MitchiLaser/MAXwel/examples/led_blink/README.md

# BIN2HEX

This example uses the 50 MHz onboard oscillator and divides the frequency down to 1 Hz. The output signal of the frequency divider is used to let an LED blink. Open the `.qpf` file with Quartus to view the source, compile the project and upload it to the device.
