MitchiLaser/MAXwel/examples/bin2hex/README.md

# BIN2HEX

This example project takes a binary number input from the 8 switches and displays the corresponding 2-digit hexadecimal number on the 7-segment displays. Open the `.qpf` file with Quartus to view the source, compile the project and upload it to the device.
