MitchiLaser/MAXwel/docs/fig/Floorplan.pdf

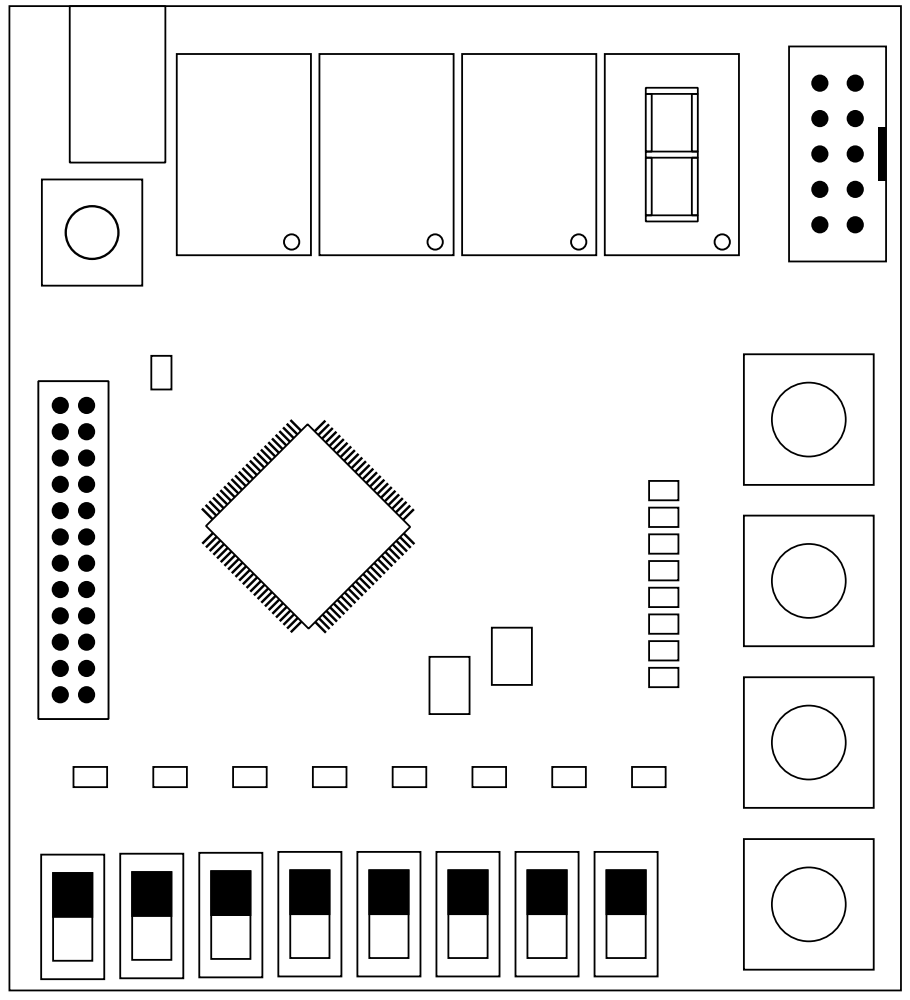
[picture p8: page 1]
