MitchiLaser/MAXwel/docs/fig/Progheader.pdf

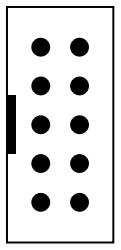
[picture p9: figure]
