MitchiLaser/MAXwel/hardware/Landing_Page_QR.png

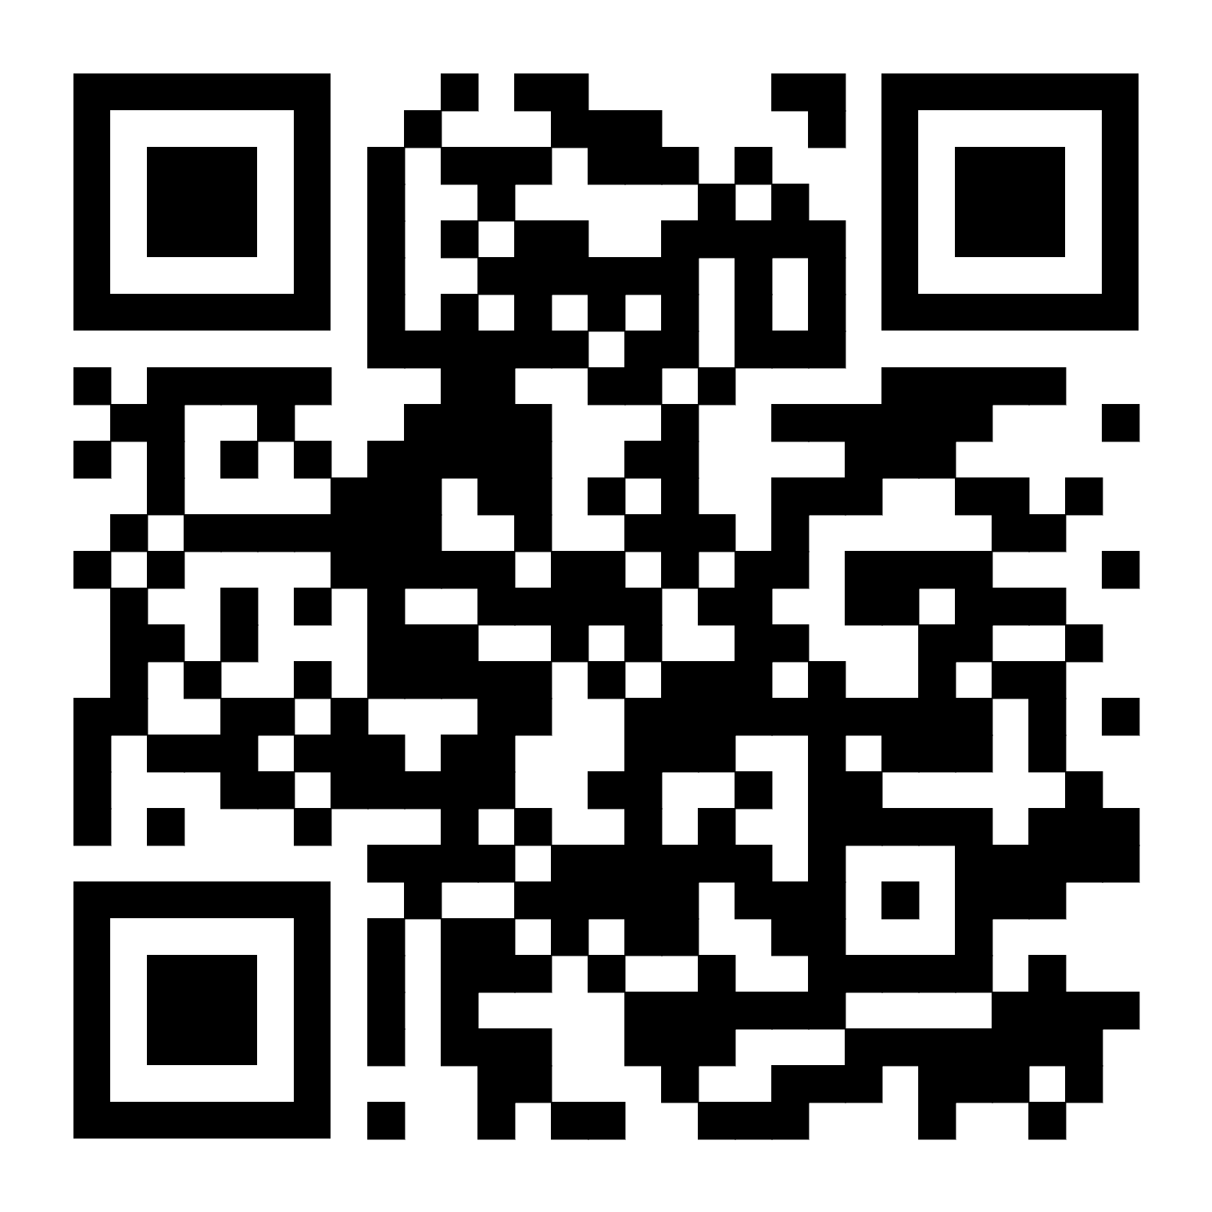
hardware/Landing_Page_QR.png
