MitchiLaser/MAXwel/hardware/MAXwel.kicad_pcb

## KiCad design hardware/MAXwel.kicad_pcb (2024-12-23)

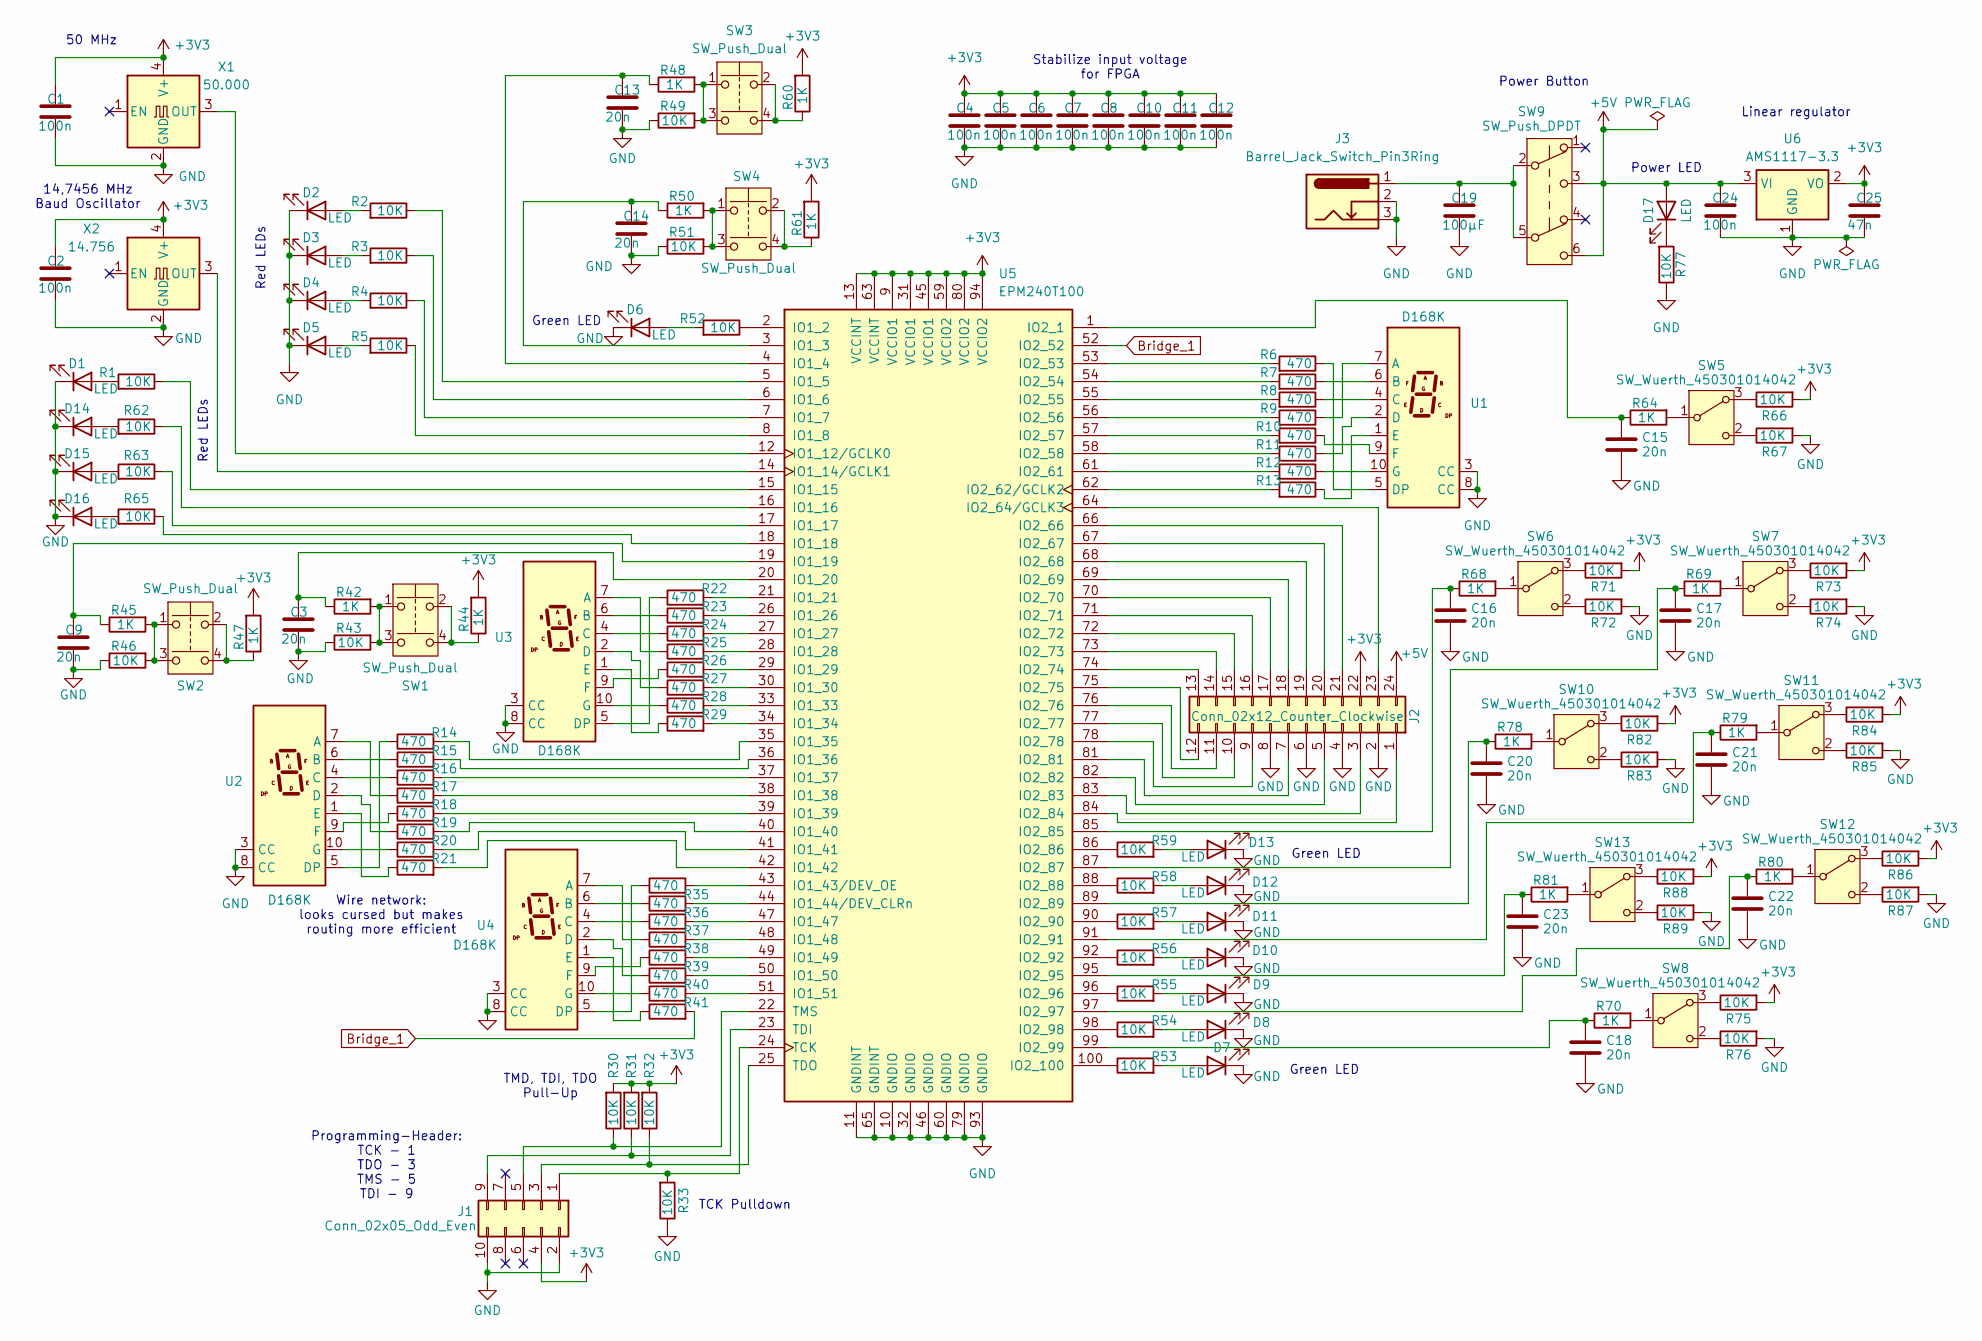
[picture p13: schematic MAXwel.kicad_sch]

Parts:
C1, C2, C4, C5, C6, C7, C8, C10, C11, C12, C24: 100n; C_0603_1608Metric_Pad1.08x0.95mm_HandSolder
C3, C9, C13, C14, C15, C16, C17, C18, C20, C21, C22, C23: 20n; C_0603_1608Metric_Pad1.08x0.95mm_HandSolder
C19: 100µF; CP_Radial_D5.0mm_P2.00mm; Part-Nr M-A 100U 16-2
C25: 47n; C_0603_1608Metric_Pad1.08x0.95mm_HandSolder
D1, D2, D3, D4, D5, D6, D7, D8, D9, D10, D11, D12, D13, D14, D15, D16, D17: LED; LED_0805_2012Metric_Pad1.15x1.40mm_HandSolder
J1: Conn_02x05_Odd_Even; IDC-Header_2x05_P2.54mm_Vertical
J2: Conn_02x12_Counter_Clockwise; PinHeader_2x12_P2.54mm_Horizontal
J3: Barrel_Jack_Switch_Pin3Ring; BarrelJack_Horizontal; Part-Nr CLIFF FCR681465
R1, R2, R3, R4, R5, R52, R53, R54, R55, R56, R57, R58, R59, R62, R63, R65, R77: 10K; R_0603_1608Metric_Pad0.98x0.95mm_HandSolder
R6, R7, R8, R9, R10, R11, R12, R13, R14, R15, R16, R17, R18, R19, R20, R21, R22, R23, R24, R25, R26, R27, R28, R29, R34, R35, R36, R37, R38, R39, R40, R41: 470; R_0603_1608Metric_Pad0.98x0.95mm_HandSolder
R30, R31, R32, R33, R43, R46, R49, R51, R66, R67, R71, R72, R73, R74, R75, R76, R82, R83, R84, R85, R86, R87, R88, R89: 10K; R_0603_1608Metric_Pad0.98x0.95mm_HandSolder; Part-Nr OMR B3F-4000
R42, R44, R45, R47, R48, R50, R60, R61, R64, R68, R69, R70, R78, R79, R80, R81: 1K; R_0603_1608Metric_Pad0.98x0.95mm_HandSolder; Part-Nr OMR B3F-4000
SW1, SW2, SW3, SW4: SW_Push_Dual; SW_PUSH-12mm
SW5, SW6, SW7, SW8, SW10, SW11, SW12, SW13: SW_Wuerth_450301014042; SW_Slide_SPDT_Straight_12.8mm_6.9mm; LCSC C5155552
SW9: SW_Push_DPDT; SW_Push_2P2T_Toggle_CK_PVA2OAH5xxxxxxV2
U1, U2: D168K; D1X8K; Part-Nr SA 56-11 RT
U3, U4: D168K; D1X8K; Part-Nr SA 56-11 RT Alternative: SC 39-11 GN
U5: EPM240T100; TQFP-100_14x14mm_P0.5mm; Part-Nr EPM 240T100 C5N
U6: AMS1117-3.3; SOT-223-3_TabPin2
X1: 50.000; Oscillator_SMD_EuroQuartz_XO53-4Pin_5.0x3.2mm_HandSoldering; LCSC C387308
X2: 14.756; Oscillator_SMD_EuroQuartz_XO53-4Pin_5.0x3.2mm_HandSoldering; LCSC C7431374

Connections:
+3V3: C1.1, C2.1, C4.1, C5.1, C6.1, C7.1, C8.1, C10.1, C11.1, C12.1, C25.1, J1.4, J2.22, R30.2, R31.2, R32.2, R44.2, R47.2, R60.2, R61.2, R66.2, R71.2, R73.2, R75.2, R82.2, R84.2, R86.2, R88.2, U5.9 (VCCIO1), U5.13 (VCCINT), U5.31 (VCCIO1), U5.45 (VCCIO1), U5.59 (VCCIO2), U5.63 (VCCINT), U5.80 (VCCIO2), U5.94 (VCCIO2), U6.2 (VO), X1.4 (V+), X2.4 (V+)
+5V: C24.1, D17.2 (A), J2.24, SW9.3 (C), SW9.6 (C), U6.3 (VI)
Bridge_1: R41.2, U5.52 (IO2_52)
GND: C1.2, C2.2, C3.2, C4.2, C5.2, C6.2, C7.2, C8.2, C9.2, C10.2, C11.2, C12.2, C13.2, C14.2, C15.2, C16.2, C17.2, C18.2, C19.2, C20.2, C21.2, C22.2, C23.2, C24.2, C25.2, D1.1 (K), D2.1 (K), D3.1 (K), D4.1 (K), D5.1 (K), D6.1 (K), D7.1 (K), D8.1 (K), D9.1 (K), D10.1 (K), D11.1 (K), D12.1 (K), D13.1 (K), D14.1 (K), D15.1 (K), D16.1 (K), J1.2, J1.10, J2.2, J2.4, J2.6, J2.8, J3.2, J3.3, R33.1, R43.1, R46.1, R49.1, R51.1, R67.2, R72.2, R74.2, R76.2, R77.1, R83.2, R85.2, R87.2, R89.2, U1.3 (CC), U1.8 (CC), U2.3 (CC), U2.8 (CC), U3.3 (CC), U3.8 (CC), U4.3 (CC), U4.8 (CC), U5.10 (GNDIO), U5.11 (GNDINT), U5.32 (GNDIO), U5.46 (GNDIO), U5.60 (GNDIO), U5.65 (GNDINT), U5.79 (GNDIO), U5.93 (GNDIO), U6.1 (GND), X1.2 (GND), X2.2 (GND)
unnamed: C19.1, J3.1, SW9.2 (B), SW9.5 (B)
unnamed: D1.2 (A), R1.2
unnamed: D2.2 (A), R2.2
unnamed: D3.2 (A), R3.2
unnamed: D4.2 (A), R4.2
unnamed: D5.2 (A), R5.2
unnamed: D6.2 (A), R52.2
unnamed: D7.2 (A), R53.2
unnamed: D8.2 (A), R54.2
unnamed: D9.2 (A), R55.2
unnamed: D10.2 (A), R56.2
unnamed: D11.2 (A), R57.2
unnamed: D12.2 (A), R58.2
unnamed: D13.2 (A), R59.2
unnamed: D14.2 (A), R62.2
unnamed: D15.2 (A), R63.2
unnamed: D16.2 (A), R65.2
unnamed: D17.1 (K), R77.2
unnamed: J1.1, R33.2, U5.24 (TCK)
unnamed: J1.3, R32.1, U5.25 (TDO)
unnamed: J1.5, R30.1, U5.22 (TMS)
unnamed: J1.9, R31.1, U5.23 (TDI)
unnamed: J2.1, U5.84 (IO2_84)
unnamed: J2.3, U5.83 (IO2_83)
unnamed: J2.5, U5.82 (IO2_82)
unnamed: J2.7, U5.81 (IO2_81)
unnamed: J2.9, U5.78 (IO2_78)
unnamed: J2.10, U5.77 (IO2_77)
unnamed: J2.11, U5.76 (IO2_76)
unnamed: J2.12, U5.75 (IO2_75)
unnamed: J2.13, U5.74 (IO2_74)
unnamed: J2.14, U5.73 (IO2_73)
unnamed: J2.15, U5.72 (IO2_72)
unnamed: J2.16, U5.71 (IO2_71)
unnamed: J2.17, U5.70 (IO2_70)
unnamed: J2.18, U5.69 (IO2_69)
unnamed: J2.19, U5.68 (IO2_68)
unnamed: J2.20, U5.67 (IO2_67)
unnamed: J2.21, U5.66 (IO2_66)
unnamed: J2.23, U5.64 (IO2_64/GCLK3)
unnamed: R42.2, R43.2, SW1.1, SW1.3
unnamed: R44.1, SW1.2, SW1.4
unnamed: R45.2, R46.2, SW2.1, SW2.3
unnamed: R47.1, SW2.2, SW2.4
unnamed: R48.2, R49.2, SW3.1, SW3.3
unnamed: R50.2, R51.2, SW4.1, SW4.3
unnamed: R60.1, SW3.2, SW3.4
unnamed: R61.1, SW4.2, SW4.4
unnamed: R66.1, SW5.3 (A)
unnamed: R64.2, SW5.1 (B)
unnamed: R67.1, SW5.2 (C)
unnamed: R71.1, SW6.3 (A)
unnamed: R68.2, SW6.1 (B)
unnamed: R72.1, SW6.2 (C)
unnamed: R73.1, SW7.3 (A)
unnamed: R69.2, SW7.1 (B)
unnamed: R74.1, SW7.2 (C)
unnamed: R75.1, SW8.3 (A)
unnamed: R70.2, SW8.1 (B)
unnamed: R76.1, SW8.2 (C)
unnamed: R82.1, SW10.3 (A)
unnamed: R78.2, SW10.1 (B)
unnamed: R83.1, SW10.2 (C)
unnamed: R84.1, SW11.3 (A)
unnamed: R79.2, SW11.1 (B)
unnamed: R85.1, SW11.2 (C)
unnamed: R86.1, SW12.3 (A)
unnamed: R80.2, SW12.1 (B)
unnamed: R87.1, SW12.2 (C)
unnamed: R88.1, SW13.3 (A)
unnamed: R81.2, SW13.1 (B)
unnamed: R89.1, SW13.2 (C)
unnamed: R9.1, U1.7 (A)
unnamed: R7.1, U1.6 (B)
unnamed: R8.1, U1.4 (C)
unnamed: R11.1, U1.2 (D)
unnamed: R6.1, U1.5 (DP)
unnamed: R13.1, U1.1 (E)
unnamed: R10.1, U1.9 (F)
unnamed: R12.1, U1.10 (G)
unnamed: R17.1, U2.7 (A)
unnamed: R15.1, U2.6 (B)
unnamed: R16.1, U2.4 (C)
unnamed: R19.1, U2.2 (D)
unnamed: R14.1, U2.5 (DP)
unnamed: R21.1, U2.1 (E)
unnamed: R18.1, U2.9 (F)
unnamed: R20.1, U2.10 (G)
unnamed: R25.1, U3.7 (A)
unnamed: R23.1, U3.6 (B)
unnamed: R24.1, U3.4 (C)
unnamed: R27.1, U3.2 (D)
unnamed: R22.1, U3.5 (DP)
unnamed: R29.1, U3.1 (E)
unnamed: R26.1, U3.9 (F)
unnamed: R28.1, U3.10 (G)
unnamed: R37.1, U4.7 (A)
unnamed: R35.1, U4.6 (B)
unnamed: R36.1, U4.4 (C)
unnamed: R39.1, U4.2 (D)
unnamed: R34.1, U4.5 (DP)
unnamed: R41.1, U4.1 (E)
unnamed: R38.1, U4.9 (F)
unnamed: R40.1, U4.10 (G)
unnamed: R52.1, U5.2 (IO1_2)
unnamed: C14.1, R50.1, U5.3 (IO1_3)
unnamed: C13.1, R48.1, U5.4 (IO1_4)
unnamed: R2.1, U5.5 (IO1_5)
unnamed: R3.1, U5.6 (IO1_6)
unnamed: R4.1, U5.7 (IO1_7)
unnamed: R5.1, U5.8 (IO1_8)
unnamed: U5.12 (IO1_12/GCLK0), X1.3 (OUT)
unnamed: U5.14 (IO1_14/GCLK1), X2.3 (OUT)
unnamed: R1.1, U5.15 (IO1_15)
unnamed: R62.1, U5.16 (IO1_16)
unnamed: R63.1, U5.17 (IO1_17)
unnamed: R65.1, U5.18 (IO1_18)
unnamed: C9.1, R45.1, U5.19 (IO1_19)
unnamed: C3.1, R42.1, U5.20 (IO1_20)
unnamed: R22.2, U5.21 (IO1_21)
unnamed: R23.2, U5.26 (IO1_26)
unnamed: R24.2, U5.27 (IO1_27)
unnamed: R25.2, U5.28 (IO1_28)
unnamed: R26.2, U5.29 (IO1_29)
unnamed: R27.2, U5.30 (IO1_30)
unnamed: R28.2, U5.33 (IO1_33)
unnamed: R29.2, U5.34 (IO1_34)
unnamed: R14.2, U5.35 (IO1_35)
unnamed: R15.2, U5.36 (IO1_36)
unnamed: R16.2, U5.37 (IO1_37)
unnamed: R17.2, U5.38 (IO1_38)
unnamed: R18.2, U5.39 (IO1_39)
unnamed: R19.2, U5.40 (IO1_40)
unnamed: R20.2, U5.41 (IO1_41)
unnamed: R21.2, U5.42 (IO1_42)
unnamed: R34.2, U5.43 (IO1_43/DEV_OE)
unnamed: R35.2, U5.44 (IO1_44/DEV_CLRn)
unnamed: R36.2, U5.47 (IO1_47)
unnamed: R37.2, U5.48 (IO1_48)
unnamed: R38.2, U5.49 (IO1_49)
unnamed: R39.2, U5.50 (IO1_50)
unnamed: R40.2, U5.51 (IO1_51)
unnamed: C15.1, R64.1, U5.1 (IO2_1)
unnamed: R6.2, U5.53 (IO2_53)
unnamed: R7.2, U5.54 (IO2_54)
unnamed: R8.2, U5.55 (IO2_55)
unnamed: R9.2, U5.56 (IO2_56)
unnamed: R10.2, U5.57 (IO2_57)
unnamed: R11.2, U5.58 (IO2_58)
unnamed: R12.2, U5.61 (IO2_61)
unnamed: R13.2, U5.62 (IO2_62/GCLK2)
unnamed: C16.1, R68.1, U5.85 (IO2_85)
unnamed: R59.1, U5.86 (IO2_86)
unnamed: C17.1, R69.1, U5.87 (IO2_87)
unnamed: R58.1, U5.88 (IO2_88)
unnamed: C20.1, R78.1, U5.89 (IO2_89)
unnamed: R57.1, U5.90 (IO2_90)
unnamed: C21.1, R79.1, U5.91 (IO2_91)
unnamed: R56.1, U5.92 (IO2_92)
unnamed: C23.1, R81.1, U5.95 (IO2_95)
unnamed: R55.1, U5.96 (IO2_96)
unnamed: C22.1, R80.1, U5.97 (IO2_97)
unnamed: R54.1, U5.98 (IO2_98)
unnamed: C18.1, R70.1, U5.99 (IO2_99)
unnamed: R53.1, U5.100 (IO2_100)

Notes on the sheet:
Green LED
Wire network: looks cursed but makes routing more efficient
Stabilize input voltage for FPGA
Programming-Header: TCK - 1 TDO - 3 TMS - 5 TDI - 9
TMD, TDI, TDO Pull-Up
Power Button
TCK Pulldown
14,7456 MHz Baud Oscillator
50 MHz
Linear regulator
Red LEDs
Power LED

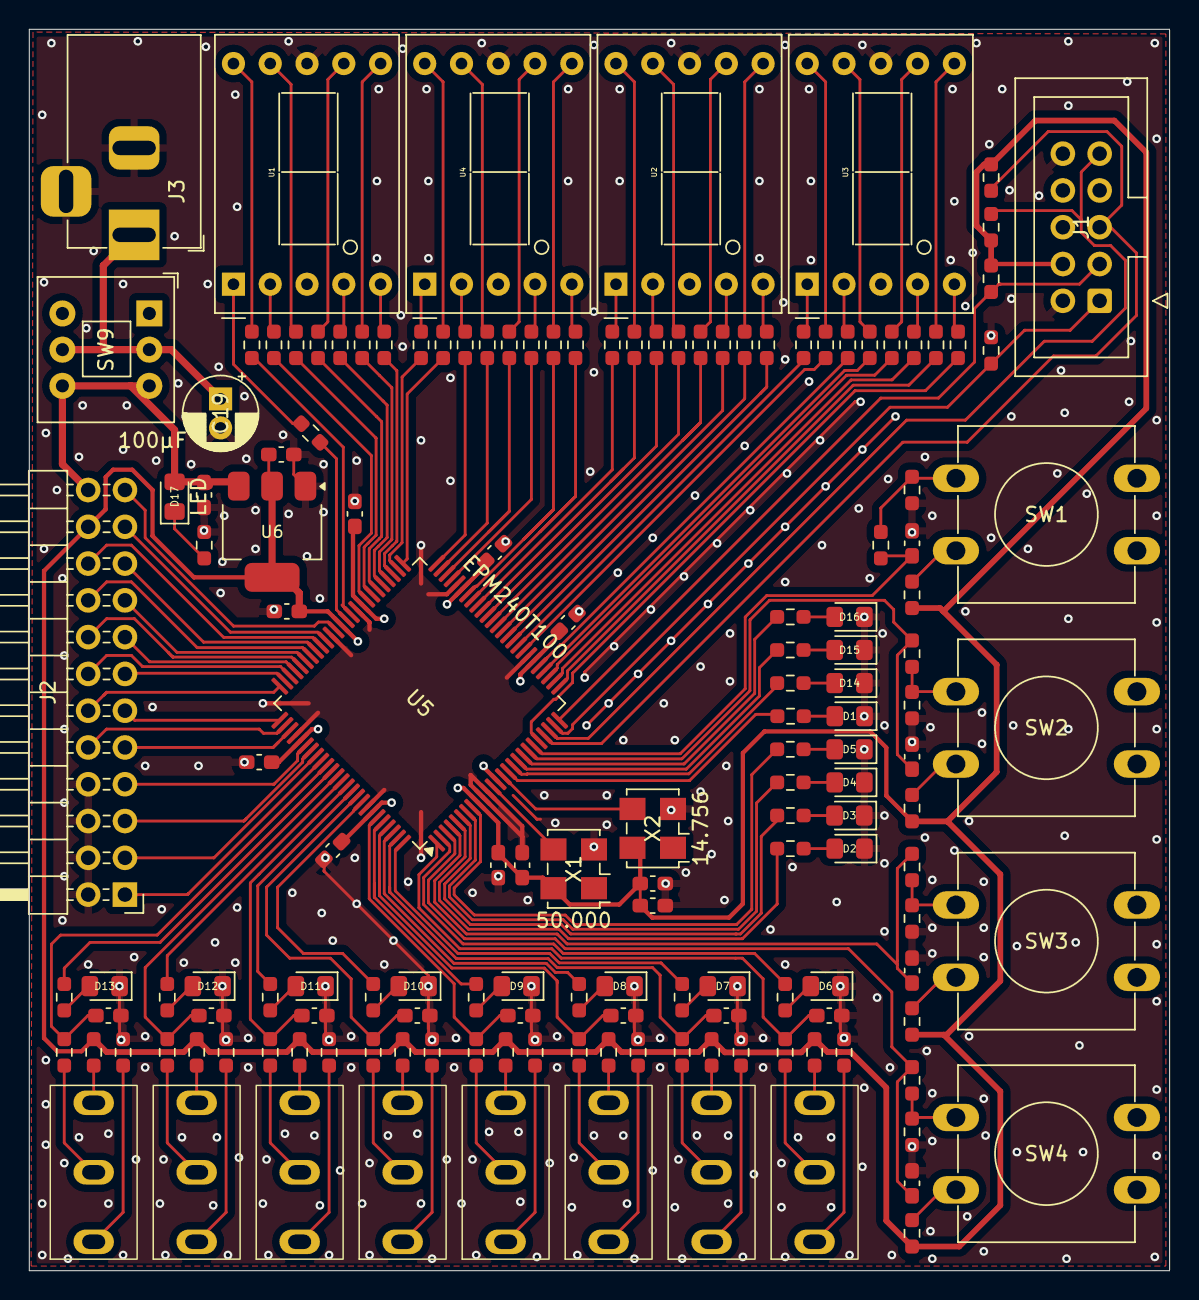
[picture p14: board MAXwel.kicad_pcb from above]

Board: 2 copper layers, 78.7 x 85.7 mm, 155 parts (0 on the bottom side), 169 nets.
