MitchiLaser/MAXwel/(commit log)

2024-06-05 all leds placed on the board
    [MAXwell.kicad_pcb, MAXwell.kicad_sch]
2024-06-05 restructure + buttons added
    [MAXwell.kicad_sch]
2024-06-06 restructured » more Space
    [MAXwell.kicad_sch]
2024-06-06 all objects placed, footprint assignment missing
    [MAXwell.kicad_sch]
2024-06-06 all footprints assigned
    [MAXwell.kicad_sch]
2024-06-06 ERC applied and fixed missing power flags
    [MAXwell.kicad_pcb, MAXwell.kicad_sch]
2024-06-07 started routing
    [MAXwell.kicad_pcb, MAXwell.kicad_sch]
2024-06-07 pcb outline defined, ready for autorouter test
    [MAXwell.kicad_pcb]
2024-06-07 partially done 1/4
    [MAXwell.kicad_pcb]
2024-06-07 nearly done
    [MAXwell.kicad_pcb]
2024-06-07 last attempt to autorouter
    [MAXwell.kicad_pcb]
2024-06-07 routing done
    [MAXwell.kicad_pcb]
2024-06-07 cleanup pcb design
    [MAXwell.kicad_pcb]
2024-06-07 replaced GND traces on backside with ground plane
    [MAXwell.kicad_pcb]
2024-06-08 established ground planes
    [MAXwell.kicad_pcb]
2024-06-08 remove reference from silkscreen
    [MAXwell.kicad_pcb]
2024-06-08 put values on silk screen
    [MAXwell.kicad_pcb]
2024-06-08 first production run
    [MAXwell.kicad_pcb]
2024-06-08 fixed wrong part number
    [MAXwell.kicad_sch]
2024-06-10 fill README with content + Rename project
    [MAXwel.kicad_pcb, MAXwel.kicad_sch]
2024-06-19 starting with landingpage and restructuring templates
2024-06-19 landing page for gh pages
2024-06-19 update README » landing page
2024-06-19 empty template for schematic project
2024-06-19 fixed missing file in schematics template
2024-06-20 fixed wrong footprint for slide switches
    [MAXwel.kicad_pcb]
2024-07-22 change resistor and capacitor size, rearrange pinheader and 7-seg connections
    [MAXwel.kicad_pcb, MAXwel.kicad_sch]
2024-07-23 rotation of FPGA
    [MAXwel.kicad_pcb, MAXwel.kicad_sch]
2024-07-23 arranged mostly all parts to reduce intersections
    [MAXwel.kicad_pcb, MAXwel.kicad_sch]
2024-07-23 switches: R and C placement optimized
    [MAXwel.kicad_pcb]
2024-07-23 3/4 of components routed on single layer
    [MAXwel.kicad_pcb]
2024-07-23 shifted everything 1 pin to the side for better power routing
    [MAXwel.kicad_pcb, MAXwel.kicad_sch]
2024-07-24 first successfull redesign
    [MAXwel.kicad_pcb, MAXwel.kicad_sch]
2024-07-24 squashing pcb layout
    [MAXwel.kicad_pcb]
2024-07-24 JTAG interface: increase spacing, add more GND for better EMI
    [MAXwel.kicad_pcb]
2024-07-29 optimized traces
    [MAXwel.kicad_pcb, MAXwel.kicad_sch]
2024-07-29 set part visibility + fabrication files
    [MAXwel.kicad_pcb]
2024-08-02 update sw_slide footprint, added part references and QR code on backside
    [MAXwel.kicad_pcb, MAXwel.kicad_sch]
2024-08-07 README: project status update
    [MAXwel.kicad_sch]
2024-08-14 new prorotype version: update pin assignment in template project
2024-08-14 update pin mapping to match new design
    [MAXwel.kicad_pcb]
2024-08-14 update docs so anybody can replicate the device
2024-08-16 added missing assignments and documentation for 7-Segments
    [template.vhd]
2024-08-17 led_blink example project
2024-12-23 add PCB data
    [MAXwel.kicad_pcb]
2025-01-22 fixed template project for lab curse: provide also GND, VCC and JK-FF symbols
2025-02-07 add new schematic symbols to template library
2025-02-07 provide reference schematics in eu and us style symbols
